minori24/NixieClockKit/Switch_Board/2018-03-22_12h35_07.png

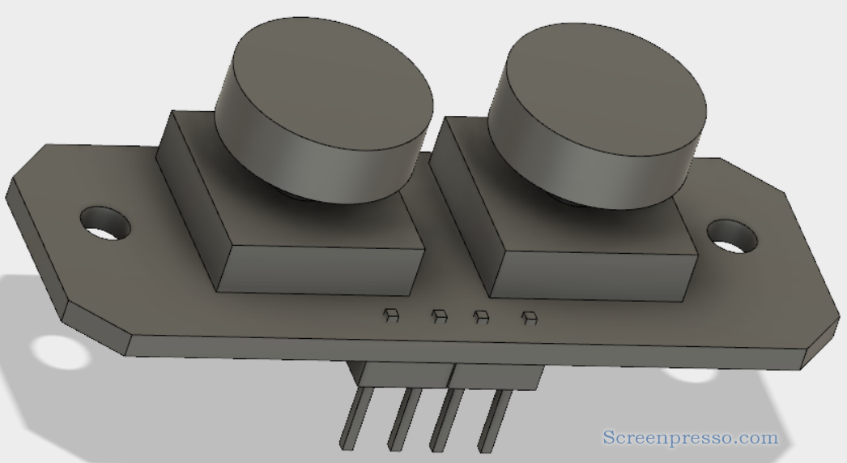
Switch_Board/2018-03-22_12h35_07.png
