minori24/NixieClockKit/BaseBoard.dxf

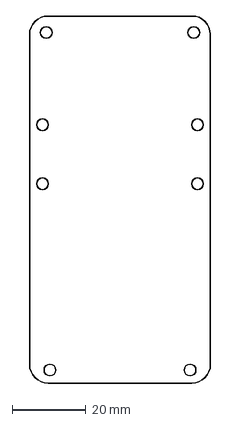
[picture p2: CAD file, 2017-10-18]
BaseBoard.dxf
49.0 x 99.5 mm
