minori24/NixieClockKit/Switch_Board/Base.dxf

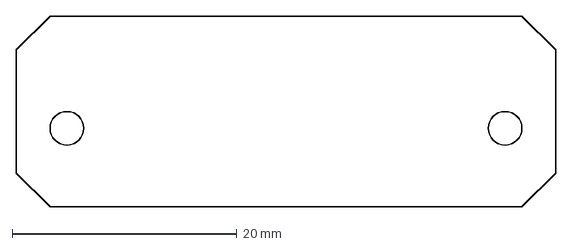
[picture p3: CAD file, 2018-03-22]
Switch_Board/Base.dxf
48.0 x 17.0 mm
