minori24/NixieClockKit/(commit log)

2017-10-10 Add BOM
    [BOM_BaseBoard.xlsx, NixieKit.kicad_pcb]
2017-10-11 Add costed BOM
    [BOM_BaseBoard.xlsx]
2017-10-12 Modify footprint
    [NixieKit.kicad_pcb, NixieKit.sch]
2017-10-13 Add header pin for RTC board PCB layout done
    [BaseBoard.dxf, NixieKit.kicad_pcb, NixieKit.sch]
2017-10-13 Modify PCB trace
    [NixieKit.kicad_pcb]
2017-10-14 Split nixie base done Issue: connector reversed
    [NixieKit.kicad_pcb, NixieKit.sch]
2017-10-16 Split board layout comp
    [NixieKit.kicad_pcb]
2017-10-18 Baseboard design done
    [BaseBoard.dxf, NixieKit-B.Cu.dxf, NixieKit-B.Mask.dxf, NixieKit-B.SilkS.dxf, NixieKit-Dwgs.User.dxf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]
2017-10-23 first gerber out
    [NixieKit - コピー.kicad_pcb, NixieKit-B.Cu.dxf, NixieKit-B.Mask.dxf, NixieKit-B.SilkS.dxf, NixieKit-Dwgs.User.dxf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]
2017-11-01 PCB Design Tuning
    [NixieKit.kicad_pcb, NixieKit.sch]
2017-11-14 working gerber
    [NixieKit.kicad_pcb, NixieKit.sch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]
2017-11-16 Modified nixie pin header position
    [NixieKit.kicad_pcb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]
2017-11-23 Add arduino code for RTC and time setting function with two buttons
    [Parts List.xlsx, bom_BaseBoard.csv]
2018-02-25 Add Arduino Code
    [NixieKit.gbl, NixieKit.gbo, NixieKit.gbs, NixieKit.gko, NixieKit.gtl, NixieKit.gto, NixieKit.gts]
2018-02-28 Add nixie tube driver lib
2018-03-04 Nixie driver library now actually works! Show seconds at last 10 sec in every minutes
2018-03-17 Add code for led dot points Moved silk coordinate to avoid via
    [BOM_BaseBoard.xlsx, NixieKit.kicad_pcb]
2018-03-18 Remove LED Function
2018-03-22 Removed unnecessary files Added back panel baseboard dxf
    [Base.dxf, NixieKit - コピー.kicad_pcb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]
2018-04-08 Fix code error Add Time LED Blink Add blanking interval to avoid ghosting
    [BOM_BaseBoard.xlsx]
2018-04-09 Add switch board
    [Switch_Board.kicad_pcb, Switch_Board.sch]
2018-04-15 Modify Switch Board
    [BOM_BaseBoard_20180415.xlsx, Switch_Board.kicad_pcb]
2018-04-16 Removed unnecessary files
    [BOM_BaseBoard.xlsx, BOM_BaseBoard_20180415.xlsx, Parts List.xlsx, bom_BaseBoard.csv]
2018-06-24 Modify LED blinking
